Hofnerd/BadgersHollow/BadgersHollowSchematic/BadgersHollowSchematic.kicad_pcb

## KiCad design BadgersHollowSchematic/BadgersHollowSchematic.kicad_pcb (2020-10-02)

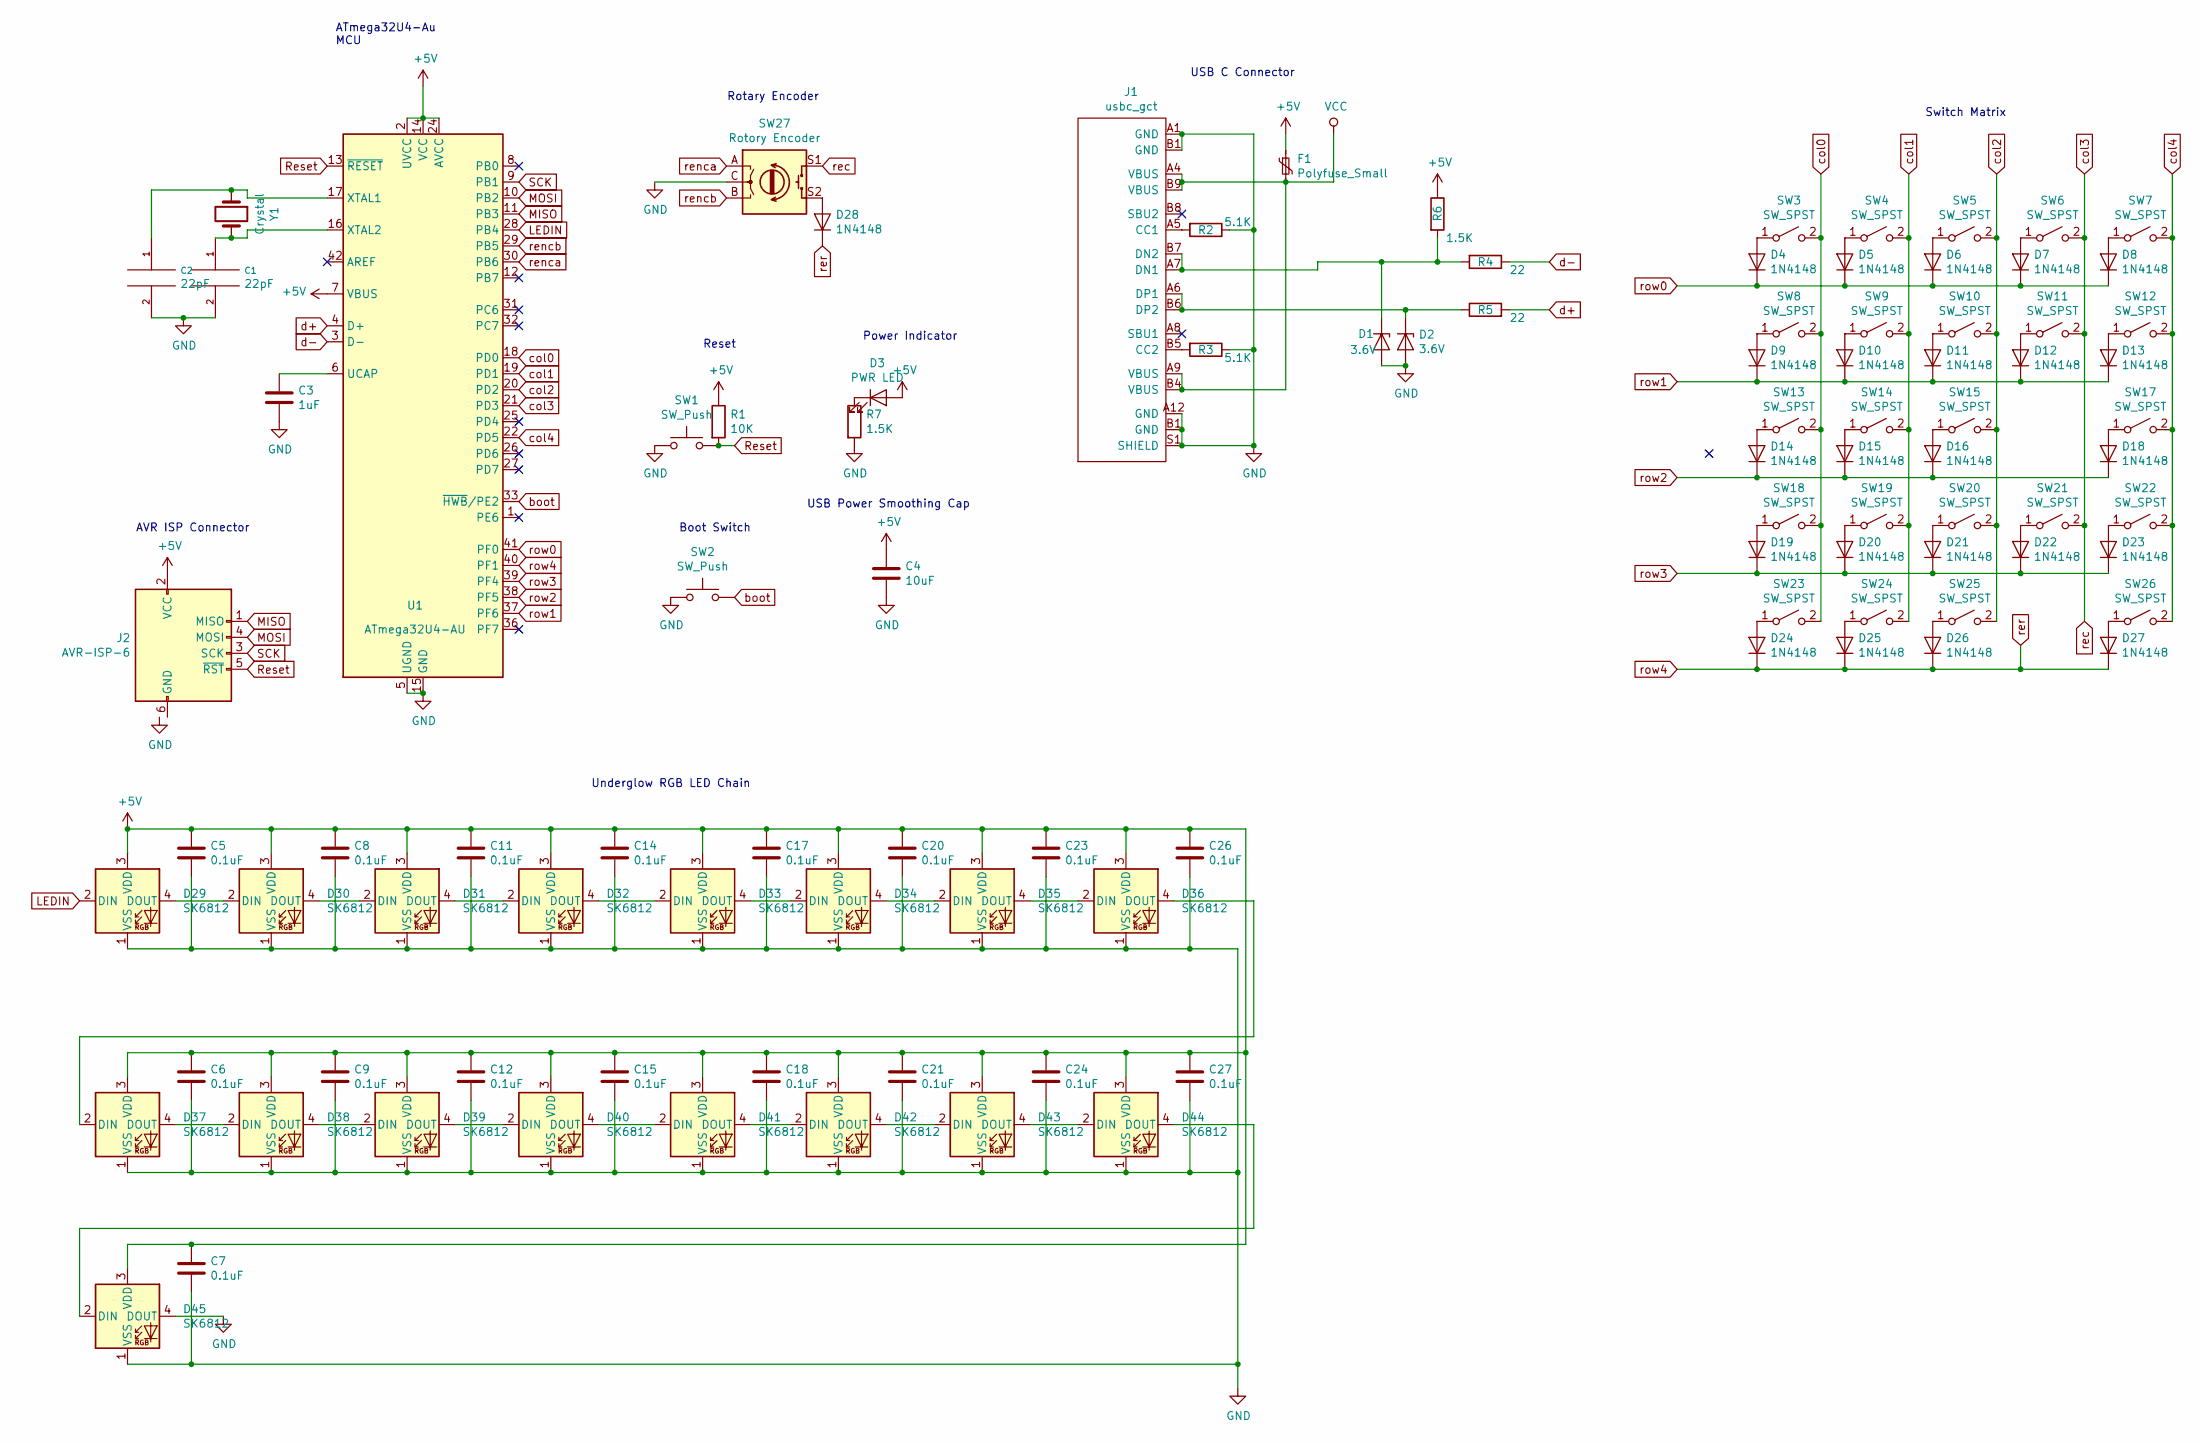
[picture p1: schematic BadgersHollowSchematic.sch]

Parts:
C1, C2: 22pF; C_1206_3216Metric_Pad1.42x1.75mm_HandSolder
C3: 1uF; R_1206_3216Metric_Pad1.42x1.75mm_HandSolder
C4: 10uF; C_0603_1608Metric_Pad1.05x0.95mm_HandSolder
C5, C6, C7, C8, C9, C11, C12, C14, C15, C17, C18, C20, C21, C23, C24, C26, C27: 0.1uF; C_0805_2012Metric_Pad1.15x1.40mm_HandSolder
D1, D2: 3.6V; D_DO-41_SOD81_P3.81mm_Vertical_AnodeUp
D3: PWR LED; LED_1206_3216Metric_Pad1.42x1.75mm_HandSolder
D4, D5, D6, D7, D8, D9, D10, D11, D12, D13, D14, D15, D16, D18, D19, D20, D21, D22, D23, D24, D25, D26, D27, D28: 1N4148; D_SOD-323_HandSoldering
D29, D30, D31, D32, D33, D34, D35, D36, D37, D38, D39, D40, D41, D42, D43, D44, D45: SK6812; LED_SK6812_PLCC4_5.0x5.0mm_P3.2mm
F1: Polyfuse_Small; Fuse_1206_3216Metric
J1: usbc_gct; USB_C_Receptacle_GCT_USB4085
J2: AVR-ISP-6; PinHeader_2x03_P2.00mm_Vertical
R1: 10K; R_1206_3216Metric_Pad1.42x1.75mm_HandSolder
R2, R3: 5.1K; R_1206_3216Metric_Pad1.42x1.75mm_HandSolder
R4, R5: 22; R_0805_2012Metric_Pad1.15x1.40mm_HandSolder
R6, R7: 1.5K; R_0805_2012Metric_Pad1.15x1.40mm_HandSolder
SW1, SW2: SW_Push; SW_PUSH_6mm
SW3, SW4, SW5, SW6, SW7, SW8, SW9, SW10, SW12, SW13, SW14, SW15, SW17, SW18, SW19, SW20, SW22, SW23, SW24, SW25, SW26: SW_SPST; SW_Cherry_MX_1.00u_PCB
SW11, SW21: SW_SPST; SW_Cherry_MX_2.00u_Vertical_PCB
SW27: Rotory Encoder; RotaryEncoder_Alps_EC11E-Switch_Vertical_H20mm_CircularMoun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
U1: ATmega32U4-AU; TQFP-44_10x10mm_P0.8mm
Y1: Crystal; Crystal_HC49-U_Vertical

Connections:
+5V: C4.1, C5.1, C6.1, C7.1, C8.1, C9.1, C11.1, C12.1, C14.1, C15.1, C17.1, C18.1, C20.1, C21.1, C23.1, C24.1, C26.1, C27.1, D3.2 (A), D29.3 (VDD), D30.3 (VDD), D31.3 (VDD), D32.3 (VDD), D33.3 (VDD), D34.3 (VDD), D35.3 (VDD), D36.3 (VDD), D37.3 (VDD), D38.3 (VDD), D39.3 (VDD), D40.3 (VDD), D41.3 (VDD), D42.3 (VDD), D43.3 (VDD), D44.3 (VDD), D45.3 (VDD), F1.1, J2.2 (VCC), R1.1, R6.1, U1.2 (UVCC), U1.7 (VBUS), U1.14 (VCC), U1.24 (AVCC), U1.34 (VCC), U1.44 (AVCC)
GND: C1.2, C2.2, C3.2, C4.2, C5.2, C6.2, C7.2, C8.2, C9.2, C11.2, C12.2, C14.2, C15.2, C17.2, C18.2, C20.2, C21.2, C23.2, C24.2, C26.2, C27.2, D1.2 (A), D2.2 (A), D29.1 (VSS), D30.1 (VSS), D31.1 (VSS), D32.1 (VSS), D33.1 (VSS), D34.1 (VSS), D35.1 (VSS), D36.1 (VSS), D37.1 (VSS), D38.1 (VSS), D39.1 (VSS), D40.1 (VSS), D41.1 (VSS), D42.1 (VSS), D43.1 (VSS), D44.1 (VSS), D45.1 (VSS), D45.4 (DOUT), J1.A1 (GND), J1.A12 (GND), J1.B1 (GND), J1.S1 (SHIELD), R2.1, R3.1, R7.2, SW1.1, SW2.1, SW27.C, U1.5 (UGND), U1.15 (GND), U1.23 (GND), U1.35 (GND), U1.43 (GND)
LEDIN: D29.2 (DIN), U1.28 (PB4)
MISO: J2.1 (MISO), U1.11 (PB3)
MOSI: J2.4 (MOSI), U1.10 (PB2)
unnamed: C1.1, U1.16 (XTAL2), Y1.2
unnamed: C2.1, U1.17 (XTAL1), Y1.1
unnamed: C3.1, U1.6 (UCAP)
unnamed: D1.1 (K), J1.A7 (DN1), J1.B7 (DN2), R4.2, R6.2
unnamed: D2.1 (K), J1.A6 (DP1), J1.B6 (DP2), R5.1
unnamed: D3.1 (K), R7.1
unnamed: D4.2 (A), SW3.1 (A)
unnamed: D5.2 (A), SW4.1 (A)
unnamed: D6.2 (A), SW5.1 (A)
unnamed: D7.2 (A), SW6.1 (A)
unnamed: D8.2 (A), SW7.1 (A)
unnamed: D9.2 (A), SW8.1 (A)
unnamed: D10.2 (A), SW9.1 (A)
unnamed: D11.2 (A), SW10.1 (A)
unnamed: D12.2 (A), SW11.1 (A)
unnamed: D13.2 (A), SW12.1 (A)
unnamed: D14.2 (A), SW13.1 (A)
unnamed: D15.2 (A), SW14.1 (A)
unnamed: D16.2 (A), SW15.1 (A)
unnamed: D18.2 (A), SW17.1 (A)
unnamed: D19.2 (A), SW18.1 (A)
unnamed: D20.2 (A), SW19.1 (A)
unnamed: D21.2 (A), SW20.1 (A)
unnamed: D22.2 (A), SW21.1 (A)
unnamed: D23.2 (A), SW22.1 (A)
unnamed: D24.2 (A), SW23.1 (A)
unnamed: D25.2 (A), SW24.1 (A)
unnamed: D26.2 (A), SW25.1 (A)
unnamed: D27.2 (A), SW26.1 (A)
unnamed: D28.2 (A), SW27.S2
unnamed: D29.4 (DOUT), D30.2 (DIN)
unnamed: D30.4 (DOUT), D31.2 (DIN)
unnamed: D31.4 (DOUT), D32.2 (DIN)
unnamed: D32.4 (DOUT), D33.2 (DIN)
unnamed: D33.4 (DOUT), D34.2 (DIN)
unnamed: D34.4 (DOUT), D35.2 (DIN)
unnamed: D35.4 (DOUT), D36.2 (DIN)
unnamed: D36.4 (DOUT), D37.2 (DIN)
unnamed: D37.4 (DOUT), D38.2 (DIN)
unnamed: D38.4 (DOUT), D39.2 (DIN)
unnamed: D39.4 (DOUT), D40.2 (DIN)
unnamed: D40.4 (DOUT), D41.2 (DIN)
unnamed: D41.4 (DOUT), D42.2 (DIN)
unnamed: D42.4 (DOUT), D43.2 (DIN)
unnamed: D43.4 (DOUT), D44.2 (DIN)
unnamed: D44.4 (DOUT), D45.2 (DIN)
unnamed: J1.A5 (CC1), R2.2
unnamed: J1.B5 (CC2), R3.2
Reset: J2.5 (~RST), R1.2, SW1.2, U1.13 (~RESET)
SCK: J2.3 (SCK), U1.9 (PB1)
VCC: F1.2, J1.A4 (VBUS), J1.A9 (VBUS), J1.B4 (VBUS), J1.B9 (VBUS)
boot: SW2.2, U1.33 (~HWB~/PE2)
col0: SW3.2 (B), SW8.2 (B), SW13.2 (B), SW18.2 (B), SW23.2 (B), U1.18 (PD0)
col1: SW4.2 (B), SW9.2 (B), SW14.2 (B), SW19.2 (B), SW24.2 (B), U1.19 (PD1)
col2: SW5.2 (B), SW10.2 (B), SW15.2 (B), SW20.2 (B), SW25.2 (B), U1.20 (PD2)
col3: SW6.2 (B), SW11.2 (B), SW21.2 (B), SW27.S1, U1.21 (PD3)
col4: SW7.2 (B), SW12.2 (B), SW17.2 (B), SW22.2 (B), SW26.2 (B), U1.22 (PD5)
d+: R5.2, U1.4 (D+)
d-: R4.1, U1.3 (D-)
renca: SW27.A, U1.30 (PB6)
rencb: SW27.B, U1.29 (PB5)
rer: D24.1 (K), D25.1 (K), D26.1 (K), D27.1 (K), D28.1 (K), U1.40 (PF1)
row0: D4.1 (K), D5.1 (K), D6.1 (K), D7.1 (K), D8.1 (K), U1.41 (PF0)
row1: D9.1 (K), D10.1 (K), D11.1 (K), D12.1 (K), D13.1 (K), U1.37 (PF6)
row2: D14.1 (K), D15.1 (K), D16.1 (K), D18.1 (K), U1.38 (PF5)
row3: D19.1 (K), D20.1 (K), D21.1 (K), D22.1 (K), D23.1 (K), U1.39 (PF4)

Notes on the sheet:
USB C Connector
Rotary Encoder
ATmega32U4-Au MCU
Reset
Boot Switch
Power Indicator
USB Power Smoothing Cap
AVR ISP Connector
Underglow RGB LED Chain
Switch Matrix

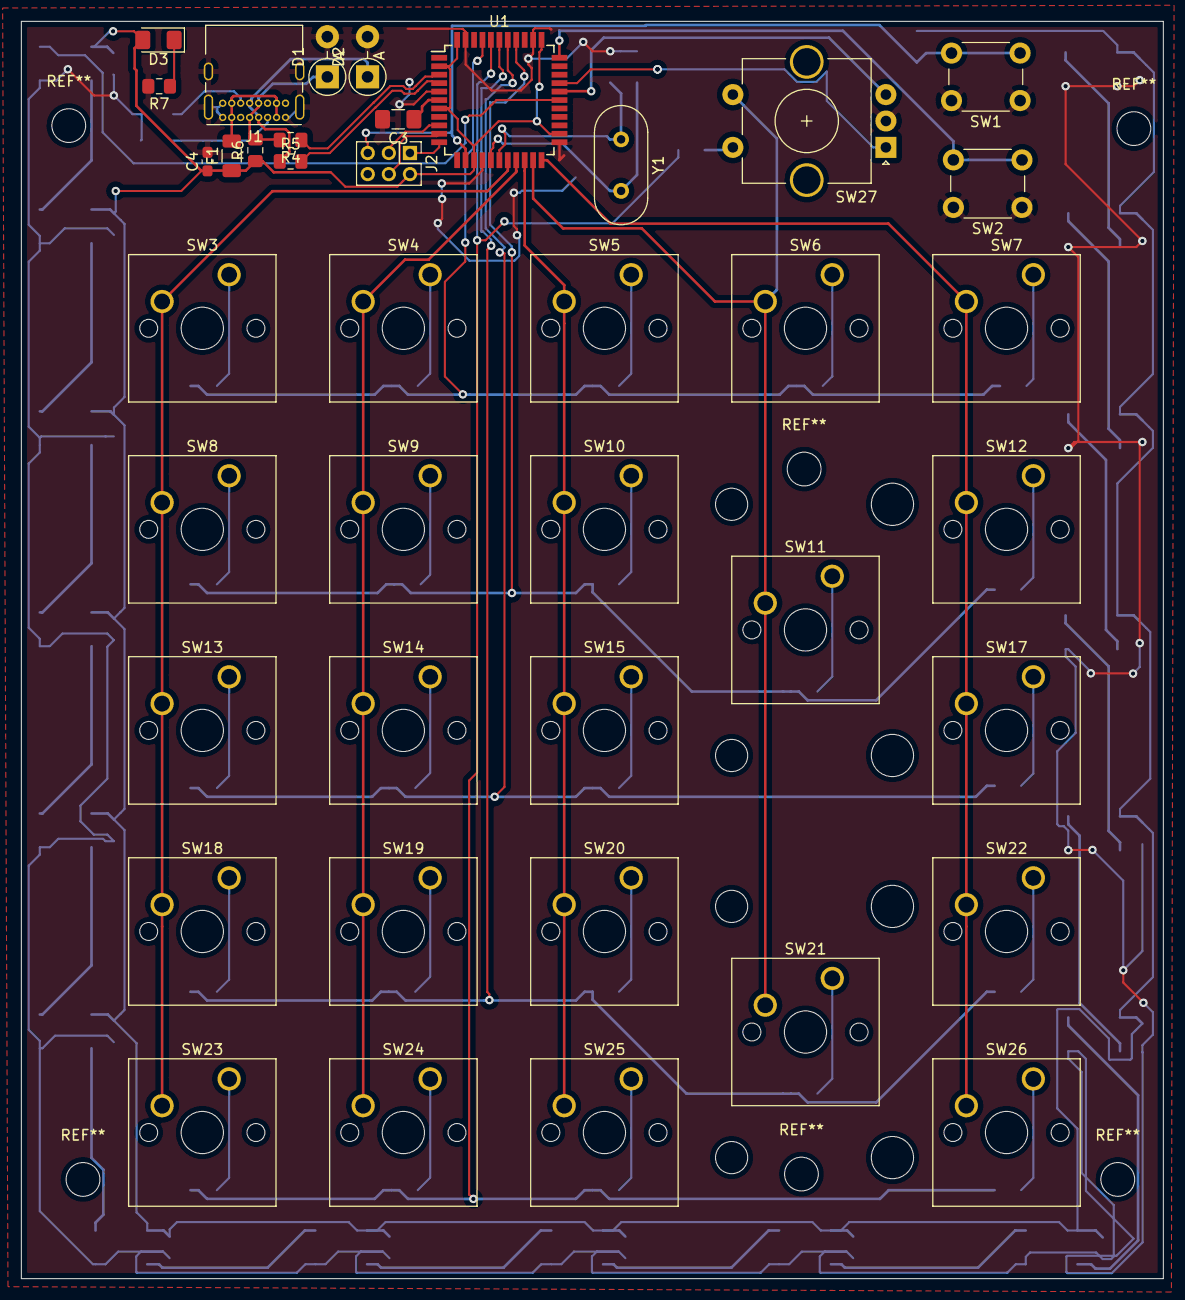
[picture p2: board BadgersHollowSchematic.kicad_pcb from above]

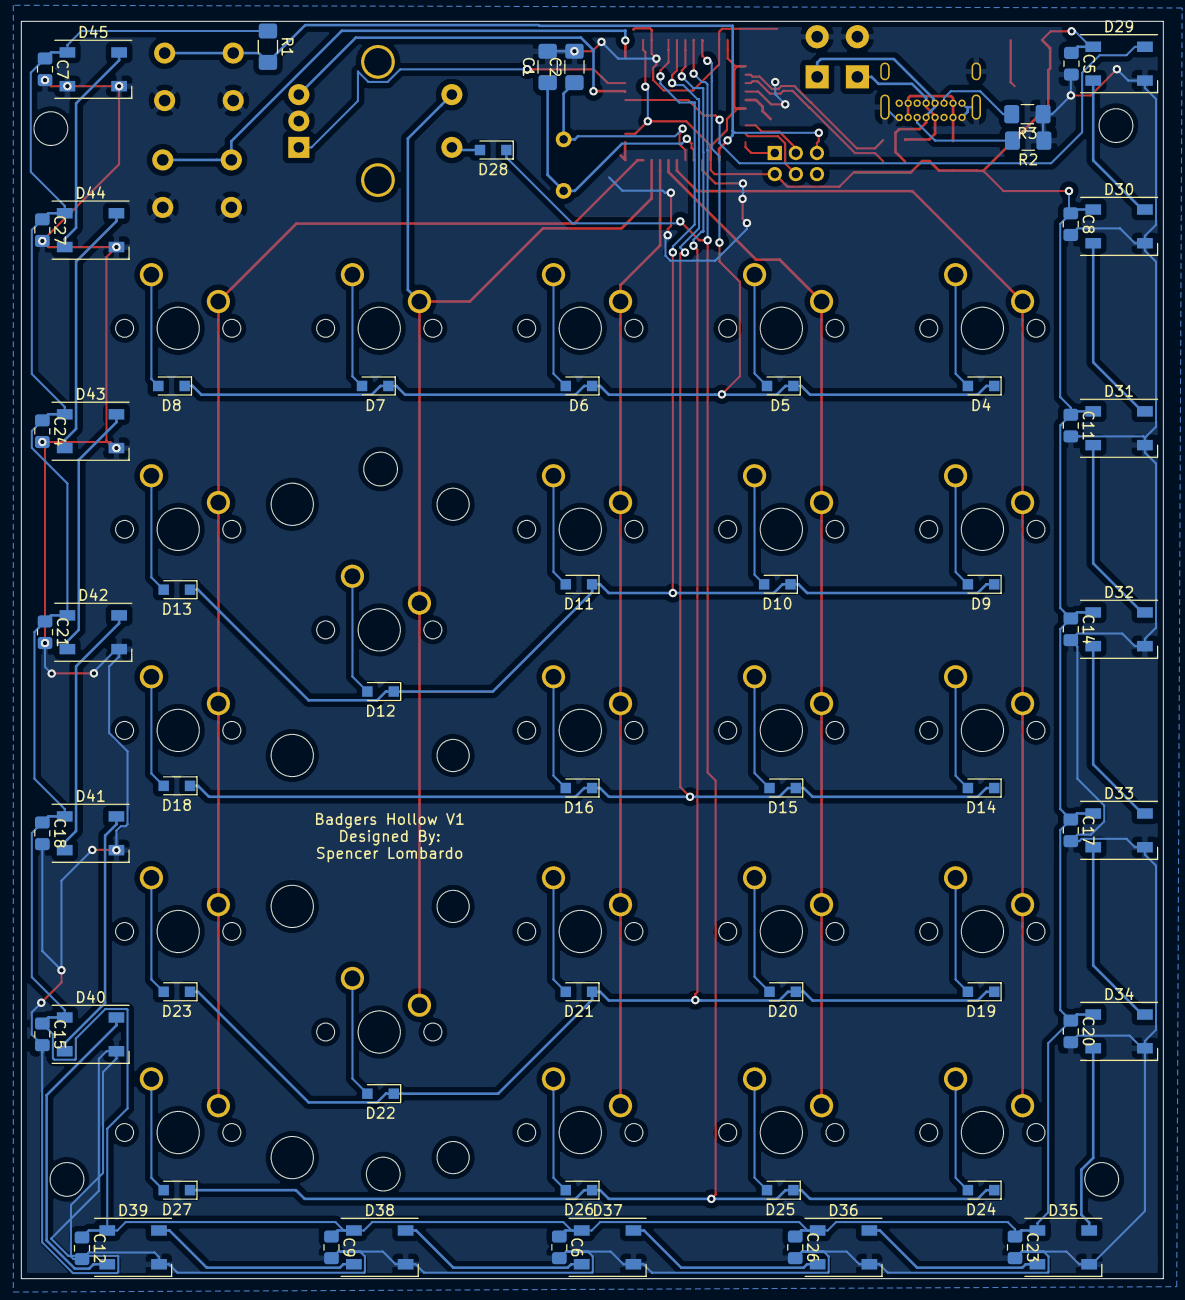
[picture p3: board BadgersHollowSchematic.kicad_pcb from below]

Board: 2 copper layers, 108.2 x 119.1 mm, 103 parts (63 on the bottom side), 71 nets.
