Hofnerd/BadgersHollow/(commit log)

2020-09-11 Schematic start, testing kicad fucntionality on new dev platform
    [BadgersHollowSchematic.kicad_pcb, BadgersHollowSchematic.sch]
2020-09-15 Schematic start. mcu and oscillator added
    [BadgersHollowSchematic.sch]
2020-09-17 Schematic down. Need to review, and map columns/rows to correct pins
    [BadgersHollowSchematic.kicad_pcb, BadgersHollowSchematic.sch]
2020-09-17 Finished Schematic, needs to be reviewed then moved to layout
    [BadgersHollowSchematic.sch]
2020-09-17 Working on layout
    [BadgersHollowSchematic.kicad_pcb, BadgersHollowSchematic.sch]
2020-09-17 Layout done. Now working on routing
    [BadgersHollowSchematic.kicad_pcb, BadgersHollowSchematic.sch]
2020-09-20 First rev of the board, with gbr files
    [BadgersHollowSchematic-B_Adhes.gbr, BadgersHollowSchematic-B_Cu.gbr, BadgersHollowSchematic-B_Mask.gbr, BadgersHollowSchematic-B_Paste.gbr, BadgersHollowSchematic-B_SilkS.gbr, BadgersHollowSchematic-Cmts_User.gbr, BadgersHollowSchematic-Dwgs_User.gbr, BadgersHollowSchematic-Eco1_User.gbr]
2020-09-27 BOE update
    [Badgers Hollow BOE.csv, Badgers Hollow BOE.xlsx, BadgersHollowSchematic.sch]
2020-09-27 Finialized Bill of Materials with sample components/links
    [Badgers Hollow BOE.csv, Badgers Hollow BOE.xlsx]
2020-09-27 Final commit before the first round of pcb purchases
    [BadgersHollowSchematic-B_Adhes.gbr, BadgersHollowSchematic-B_Cu.gbr, BadgersHollowSchematic-B_Mask.gbr, BadgersHollowSchematic-B_Paste.gbr, BadgersHollowSchematic-B_SilkS.gbr, BadgersHollowSchematic-Cmts_User.gbr, BadgersHollowSchematic-Dwgs_User.gbr, BadgersHollowSchematic-Eco1_User.gbr]
2020-10-02 Updated Push
    [Badgers Hollow BOE.xlsx]
2020-10-02 Updated usbb differential track lengths
    [BadgersHollowSchematic-B_Adhes.gbr, BadgersHollowSchematic-B_Cu.gbr, BadgersHollowSchematic-B_Mask.gbr, BadgersHollowSchematic-B_Paste.gbr, BadgersHollowSchematic-B_SilkS.gbr, BadgersHollowSchematic-Cmts_User.gbr, BadgersHollowSchematic-Dwgs_User.gbr, BadgersHollowSchematic-Eco1_User.gbr]
2020-10-02 Final V1 before first test run order
    [BadgersHollowSchematic-B_Adhes.gbr, BadgersHollowSchematic-B_Cu.gbr, BadgersHollowSchematic-B_Mask.gbr, BadgersHollowSchematic-B_Paste.gbr, BadgersHollowSchematic-B_SilkS.gbr, BadgersHollowSchematic-Cmts_User.gbr, BadgersHollowSchematic-Dwgs_User.gbr, BadgersHollowSchematic-Eco1_User.gbr]
